FodorZsofi/Food-Dispenser/README.md

# Food-Dispenser

Arduino project.

This food dispenser can be controlled via the buttons found on the setup, or can also be controlled remotely from our phoens via bluetooth connection.
The main components of this food dispenser are the button, the leds tha turn on if the environment is dark, which is signaled by the light sensor, and a bluetooth module which provides the connection to our phone
